evyd13/atom47/README.md

# Atom47

This is the repository for the Atom47. At the moment you'll find Revision 4 AND 5 of the PCB, the final plate file and a design for a 3d printed case.

The Apache2 license apply to all of these works.
