evyd13/atom47/pcb-files/README.md

# Atom47 PCB

## Rev5 (with per key RGB)
Atom47 rev5

## Rev4
Atom47 rev4
