evyd13/atom47/pcb-files/rev5-c/manufacturing/Atom47 Rev5-C BOM.xls

Atom47 Rev5-C BOM
Manufacturer | Manufacturer Part Number (required) | Designator (required) | Qty (required) | Description (required) | Case | SMD ,BGA,LCC,OR TH | Top/Bottom | points (number of contacts the IC has in each board) | Total points (number of contacts per BOM line has) | Comment
Samsung Electro-Mechanics | CL10B104KB8NNNC | C1, C2, C3, C7, C10, C12 | 6 | 100nf capacitor | 0603 | SMD | Bottom
Samsung Electro-Mechanics | CL10A475KP8NNNC | C4 | 1 | 4.7uf capacitor | 0603 | SMD | Bottom
Samsung Electro-Mechanics | CL10A105KB8NNNC | C5 | 1 | 1uf capacitor | 0603 | SMD | Bottom
Samsung Electro-Mechanics | CL10A474KP8NNNC | C6, C9, C11, C13 | 4 | 0.47uf capacitor | 0603 | SMD | Bottom
Shenzhen Zhenhua XinYun Elec | CA45-A-10V-22uF-M | C8 | 1 | 22u tantalum capacitor | 3216 | SMD | Bottom
Changjiang Electronics Tech | 1N4148WS | D1-D24, D26, D27, D29-D43, D45, D47, D49, D50-D52 | 47 | Switching diode | SOD-323 | SMD | Bottom
Walsin Tech Corp | WR06X103JTL | R3, R4, R7 | 3 | 10k ohm resistor | 0603 | SMD | Bottom
Walsin Tech Corp | WR06X203JTL | R5 | 1 | 20k ohm resistor | 0603 | SMD | Bottom
Walsin Tech Corp | WR06X104JTL | R6 | 1 | 100k ohm resistor | 0603 | SMD | Bottom
Walsin Tech Corp | WR06X202JTL | R8, R9 | 2 | 2k ohm resistor | 0603 | SMD | Bottom
Walsin Tech Corp | WR06X220JTL | R1, R2 | 2 | 22 ohm resistor | 0603 | SMD | Bottom
Walsin Tech Corp | WR06X512JTL | R10, R11 | 2 | 5.1k ohm resistor | 0603 | SMD | Bottom
Microchip Tech | ATMEGA32U4-MU | U1 | 1 | Microcontroller | QFN-44 | SMD | Bottom |  |  | Do not substitute
STMicroelectronics | USBLC6-2SC6 | U2 | 1 | Diode ESD | SOT-23-6 | SMD | Bottom |  |  | Do not substitute
Murata Electronics | CSTNE16M0V530000R0 | X1 | 1 | Resonator |  | SMD | Bottom |  |  | Do not substitute
TLC Electronic | TLC-FSMD050 | F1 | 1 | PTC Fuse | 0603 | SMD | Bottom |  |  | Do not substitute
TLC Electronic | TLC-PSMD050 | F2 | 1 | PTC Fuse | 0805 | SMD | Bottom |  |  | Do not substitute
Korean Hroparts Elec | TYPE-C-31-M-12 | J1 | 1 | USB type C receptacle |  | SMD+TH | Bottom |  |  | Do not substitute
LXR-CP | CP-6028SMDRGB-CA | RGB1-RGB24, RGB26,RGB27, RGB28, RGB29-RGB43, RGB45, RGB47, RGB49, RGB50-RGB52 | 48 | RGB led |  | SMD | Bottom |  |  | Do not substitute
Lumissil | IS31FL3733B-QFLS4-TR | U3 | 1 | LED matrix driver | QFN-48 | SMD | Bottom
