evyd13/atom47/case-files/3D printed case.step

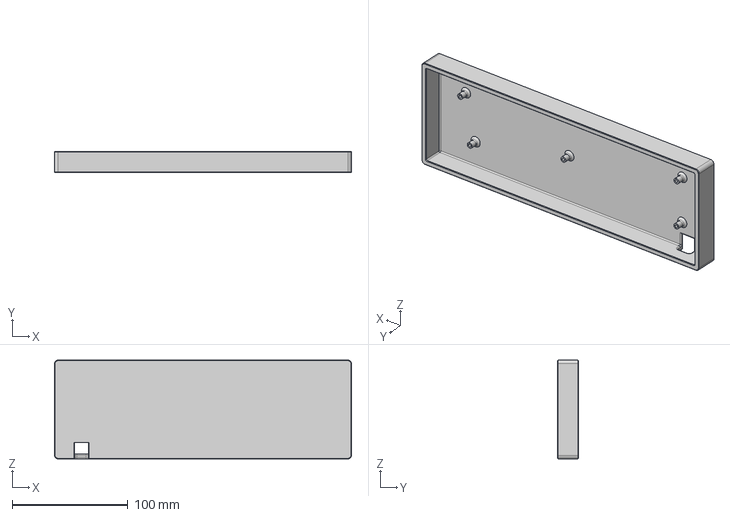
[picture p3: CAD file, 2020-06-01]
case-files/3D printed case.step
256.9 x 18.5 x 85.4 mm
