evyd13/atom47/plate-files/atom47_core_layout.dxf

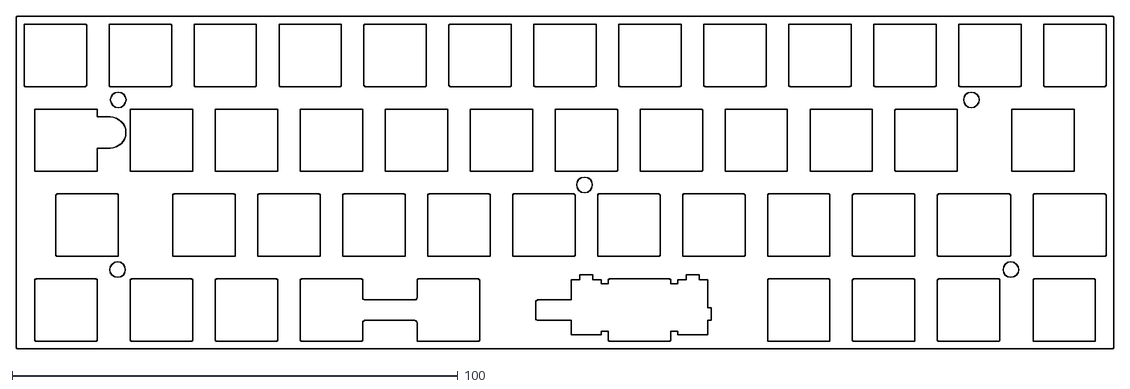
[picture p4: CAD file, 2021-02-24]
plate-files/atom47_core_layout.dxf
246.2 x 74.7
