evyd13/atom47/plate-files/atom47_minitomic_layout.dxf

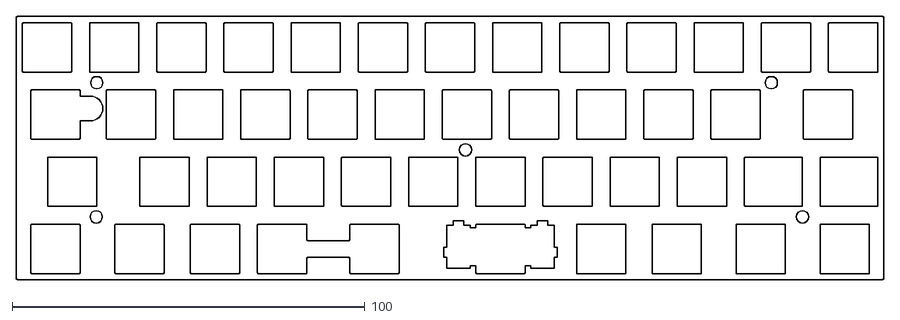
[picture p5: CAD file, 2021-02-24]
plate-files/atom47_minitomic_layout.dxf
246.2 x 74.7
