evyd13/atom47/(list of files, cad)

Other CAD files:
plate-files/atom47_plate.FCStd
case-files/3D printed case.f3z
case-files/3D printed case.stl
