evyd13/atom47/pcb-files/rev5-c/atom47-rev5-c.kicad_pcb

## KiCad design pcb-files/rev5-c/atom47-rev5-c.kicad_pcb (2022-03-01)

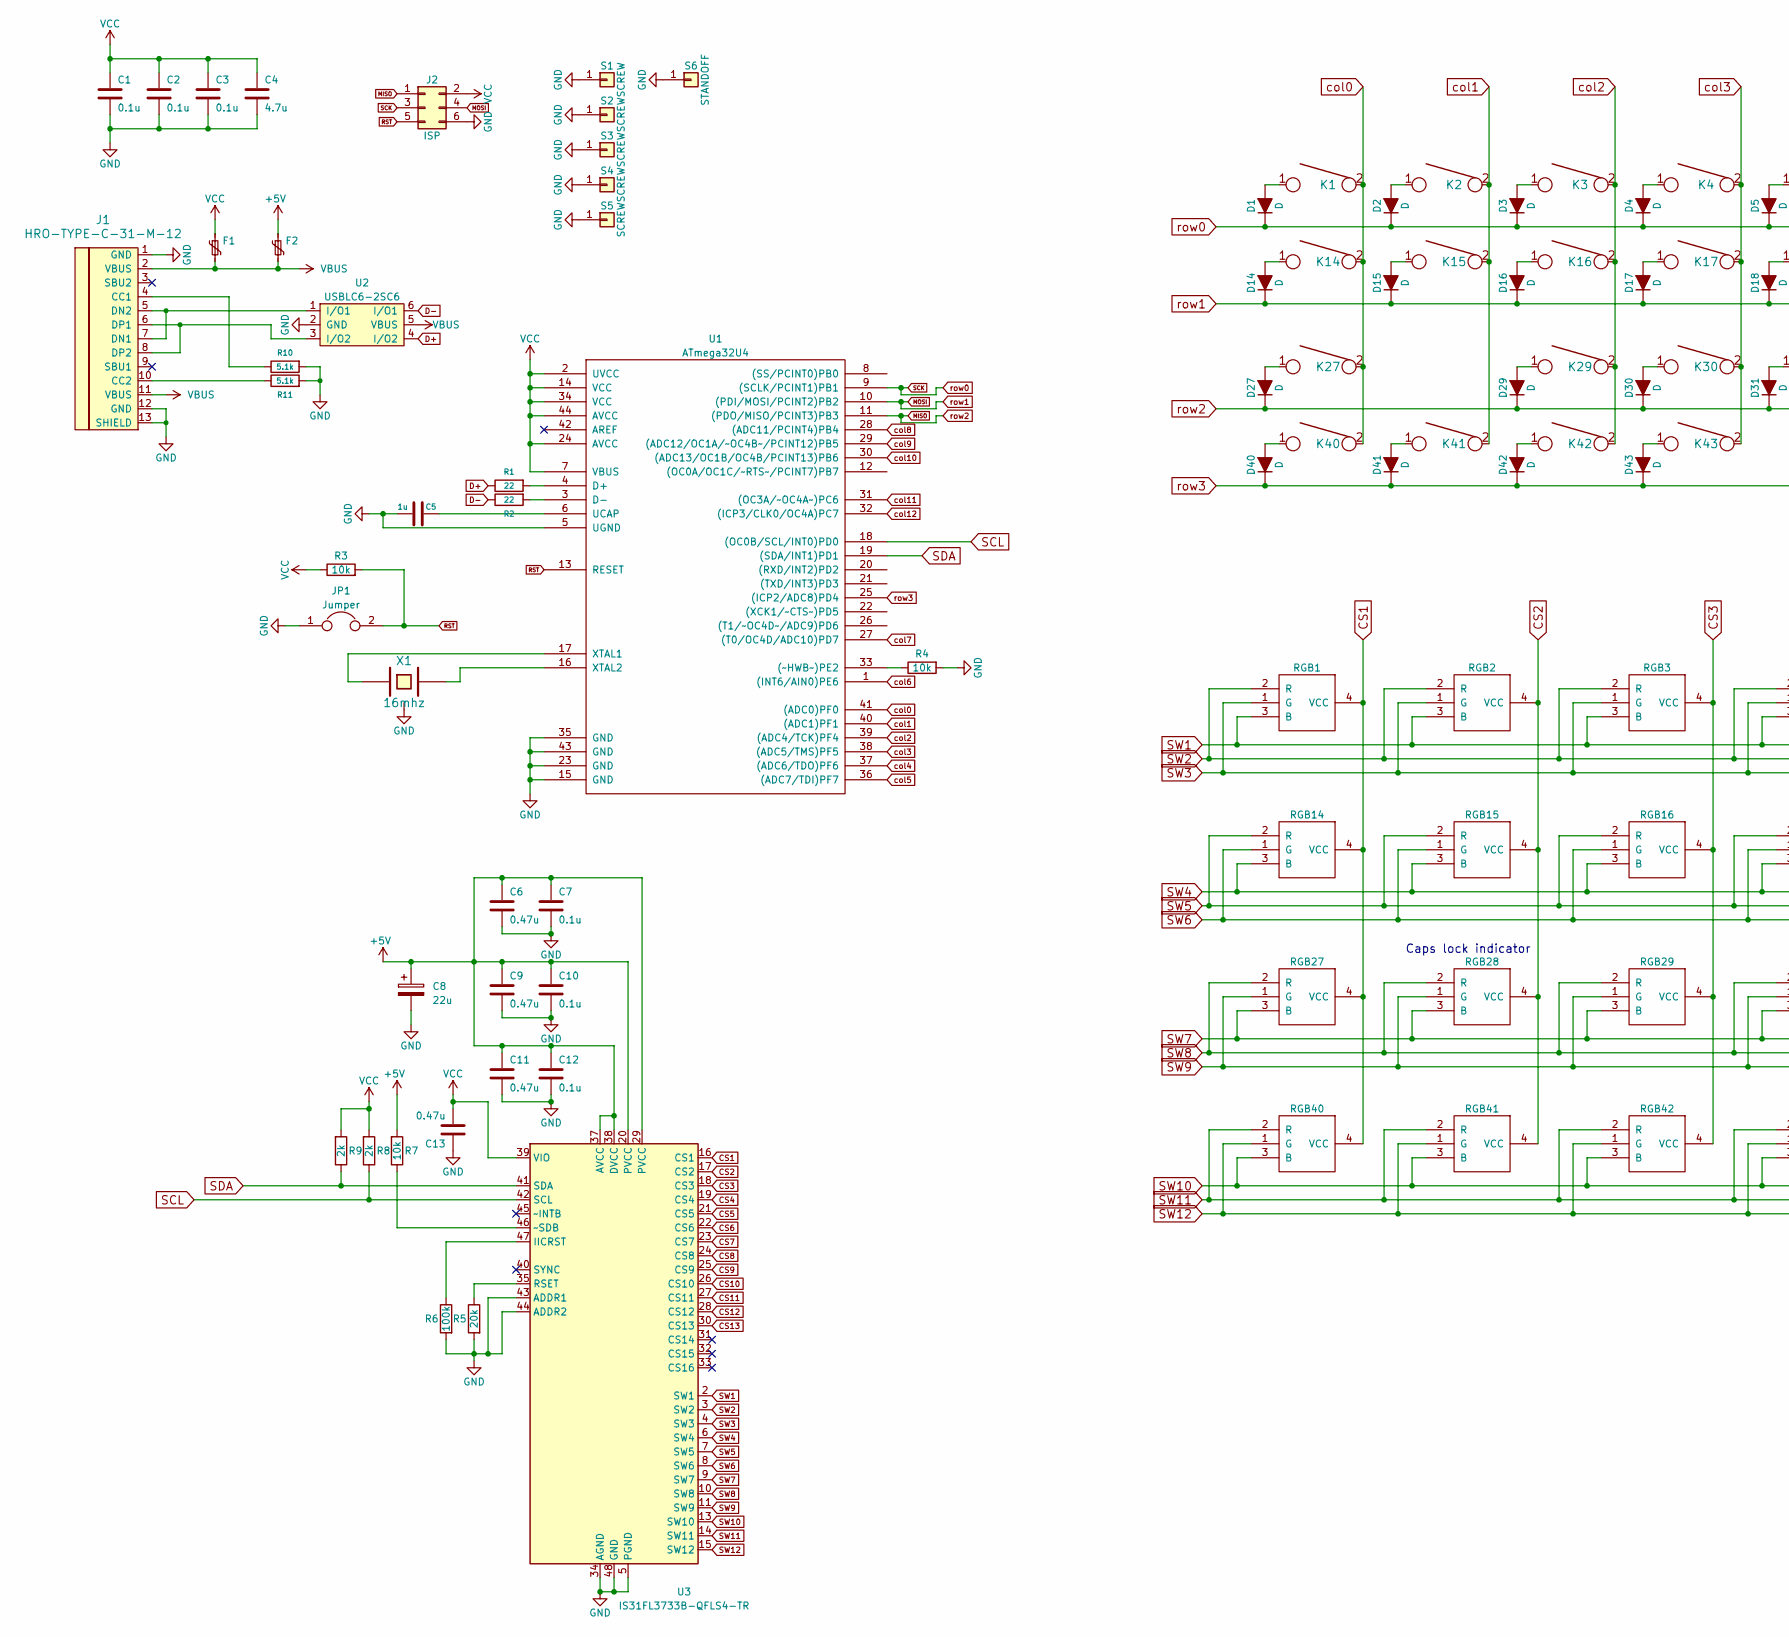
[picture p6: schematic atom47-rev5-c.kicad_sch, part in row 1, column 1]

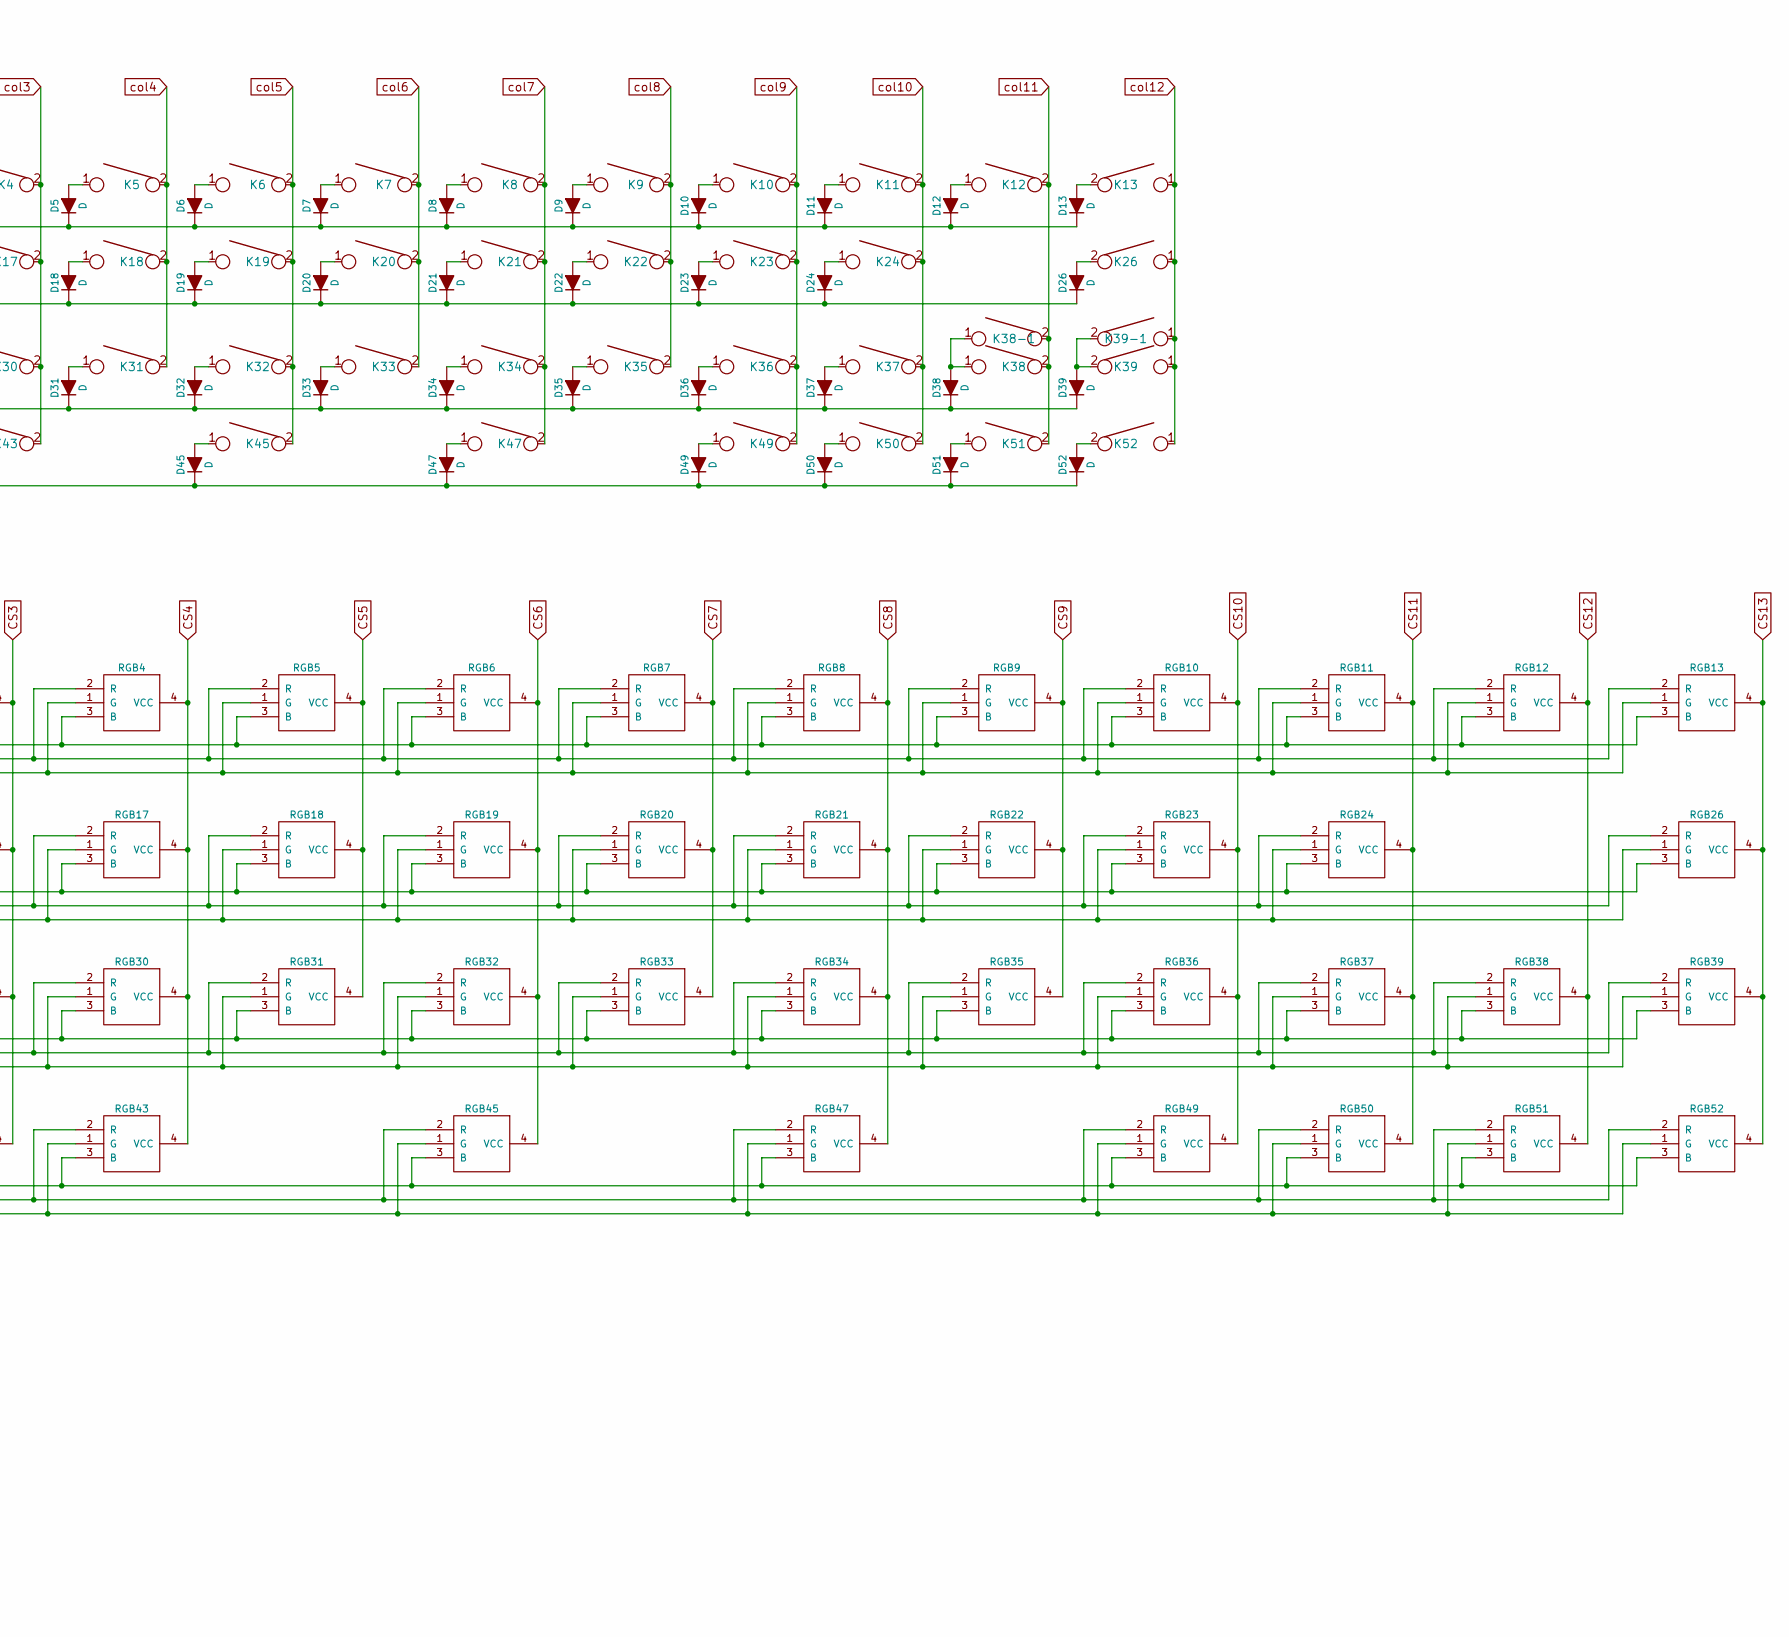
[picture p7: schematic atom47-rev5-c.kicad_sch, part in row 1, column 2]

Parts:
C1, C2, C3, C7, C10, C12: 0.1u; C_0603
C4: 4.7u; C_0603
C5: 1u; C_0603
C6, C9, C11, C13: 0.47u; C_0603
C8: 22u; CP_EIA-3216-10_Kemet-I
D1, D2, D3, D4, D5, D6, D7, D8, D9, D10, D11, D12, D13, D14, D15, D16, D17, D18, D19, D20, D21, D22, D23, D24, D26, D27, D29, D30, D31, D32, D33, D34, D35, D36, D37, D38, D39, D40, D41, D42, D43, D45, D47, D49, D50, D51, D52: D; D_SOD-323
F1: Polyfuse_Small; R_0603
F2: Polyfuse_Small; R_0805
J1: HRO-TYPE-C-31-M-12
J2: ISP; isp_standard
JP1: Jumper; reset
K1, K2, K3, K4, K5, K6, K7, K8, K9, K10, K11, K12, K13, K15, K16, K17, K18, K19, K20, K21, K22, K23, K24, K29, K30, K31, K32, K33, K34, K35, K36, K37, K38-1, K39, K41, K42, K43, K49, K50, K51: KEYSW; CHERRY_PLATE_100H
K14, K38, K39-1, K40, K52: KEYSW; CHERRY_PLATE_125H
K26, K27, K45: KEYSW; CHERRY_PLATE_175H
K47: KEYSW; CHERRY_PLATE_275H
R1, R2: 22; R_0603
R3, R4, R7: 10k; R_0603
R5: 20k; R_0603
R6: 100k; R_0603
R8, R9: 2k; R_0603
R10, R11: 5.1k; R_0603
RGB1, RGB2, RGB3, RGB4, RGB5, RGB6, RGB7, RGB8, RGB9, RGB10, RGB11, RGB12, RGB13, RGB14, RGB15, RGB16, RGB17, RGB18, RGB19, RGB20, RGB21, RGB22, RGB23, RGB24, RGB26, RGB27, RGB28, RGB29, RGB30, RGB31, RGB32, RGB33, RGB34, RGB35, RGB36, RGB37, RGB38, RGB39, RGB40, RGB41, RGB42, RGB43, RGB45, RGB47, RGB49, RGB50, RGB51, RGB52: RGB_6028; CP-6028SMDRGB-CA
S1, S2, S3, S4, S5: SCREW; Vortex_Core_screw
S6: STANDOFF; vortex_standoff
U1: ATmega32U4; ATMEGA32U4-MU
U2: USBLC6-2SC6
U3: IS31FL3733B-QFLS4-TR; QFN-48-1EP_6x6mm_P0.4mm_EP4.2x4.2mm
X1: 16mhz; Resonator_SMD_muRata_CSTNExxV-3Pin-p1.2

Connections:
+5V: C6.1, C7.1, C8.1, C9.1, C10.1, C11.1, C12.1, F2.1, R7.2, U3.20 (PVCC), U3.29 (PVCC), U3.37 (AVCC), U3.38 (DVCC)
CS1: RGB1.4 (VCC), RGB14.4 (VCC), RGB27.4 (VCC), RGB40.4 (VCC), U3.16 (CS1)
CS2: RGB2.4 (VCC), RGB15.4 (VCC), RGB28.4 (VCC), RGB41.4 (VCC), U3.17 (CS2)
CS3: RGB3.4 (VCC), RGB16.4 (VCC), RGB29.4 (VCC), RGB42.4 (VCC), U3.18 (CS3)
CS4: RGB4.4 (VCC), RGB17.4 (VCC), RGB30.4 (VCC), RGB43.4 (VCC), U3.19 (CS4)
CS5: RGB5.4 (VCC), RGB18.4 (VCC), RGB31.4 (VCC), U3.21 (CS5)
CS6: RGB6.4 (VCC), RGB19.4 (VCC), RGB32.4 (VCC), RGB45.4 (VCC), U3.22 (CS6)
CS7: RGB7.4 (VCC), RGB20.4 (VCC), RGB33.4 (VCC), U3.23 (CS7)
CS8: RGB8.4 (VCC), RGB21.4 (VCC), RGB34.4 (VCC), RGB47.4 (VCC), U3.24 (CS8)
CS9: RGB9.4 (VCC), RGB22.4 (VCC), RGB35.4 (VCC), U3.25 (CS9)
CS10: RGB10.4 (VCC), RGB23.4 (VCC), RGB36.4 (VCC), RGB49.4 (VCC), U3.26 (CS10)
CS11: RGB11.4 (VCC), RGB24.4 (VCC), RGB37.4 (VCC), RGB50.4 (VCC), U3.27 (CS11)
CS12: RGB12.4 (VCC), RGB38.4 (VCC), RGB51.4 (VCC), U3.28 (CS12)
CS13: RGB13.4 (VCC), RGB26.4 (VCC), RGB39.4 (VCC), RGB52.4 (VCC), U3.30 (CS13)
D+: R1.1, U2.4 (I/O2)
D-: R2.1, U2.6 (I/O1)
GND: C1.2, C2.2, C3.2, C4.2, C5.2, C6.2, C7.2, C8.2, C9.2, C10.2, C11.2, C12.2, C13.1, J1.1 (GND), J1.12 (GND), J1.13 (SHIELD), J2.6, JP1.1, R4.2, R5.2, R6.2, R10.2, R11.2, S1.1, S2.1, S3.1, S4.1, S5.1, S6.1, U1.5 (UGND), U1.15 (GND), U1.23 (GND), U1.35 (GND), U1.43 (GND), U2.2 (GND), U3.5 (PGND), U3.12 (PGND), U3.34 (AGND), U3.43 (ADDR1), U3.44 (ADDR2), U3.48 (GND), U3.49 (GND), X1.3
MISO: D27.1 (K), D29.1 (K), D30.1 (K), D31.1 (K), D32.1 (K), D33.1 (K), D34.1 (K), D35.1 (K), D36.1 (K), D37.1 (K), D38.1 (K), D39.1 (K), J2.1, U1.11 ((PDO/MISO/PCINT3)PB3)
MOSI: D14.1 (K), D15.1 (K), D16.1 (K), D17.1 (K), D18.1 (K), D19.1 (K), D20.1 (K), D21.1 (K), D22.1 (K), D23.1 (K), D24.1 (K), D26.1 (K), J2.4, U1.10 ((PDI/MOSI/PCINT2)PB2)
unnamed: C5.1, U1.6 (UCAP)
unnamed: D1.2 (A), K1.1
unnamed: D2.2 (A), K2.1
unnamed: D3.2 (A), K3.1
unnamed: D4.2 (A), K4.1
unnamed: D5.2 (A), K5.1
unnamed: D6.2 (A), K6.1
unnamed: D7.2 (A), K7.1
unnamed: D8.2 (A), K8.1
unnamed: D9.2 (A), K9.1
unnamed: D10.2 (A), K10.1
unnamed: D11.2 (A), K11.1
unnamed: D12.2 (A), K12.1
unnamed: D13.2 (A), K13.2
unnamed: D14.2 (A), K14.1
unnamed: D15.2 (A), K15.1
unnamed: D16.2 (A), K16.1
unnamed: D17.2 (A), K17.1
unnamed: D18.2 (A), K18.1
unnamed: D19.2 (A), K19.1
unnamed: D20.2 (A), K20.1
unnamed: D21.2 (A), K21.1
unnamed: D22.2 (A), K22.1
unnamed: D23.2 (A), K23.1
unnamed: D24.2 (A), K24.1
unnamed: D26.2 (A), K26.2
unnamed: D27.2 (A), K27.1
unnamed: D29.2 (A), K29.1
unnamed: D30.2 (A), K30.1
unnamed: D31.2 (A), K31.1
unnamed: D32.2 (A), K32.1
unnamed: D33.2 (A), K33.1
unnamed: D34.2 (A), K34.1
unnamed: D35.2 (A), K35.1
unnamed: D36.2 (A), K36.1
unnamed: D37.2 (A), K37.1
unnamed: D38.2 (A), K38.1, K38-1.1
unnamed: D39.2 (A), K39.2, K39-1.2
unnamed: D40.2 (A), K40.1
unnamed: D41.2 (A), K41.1
unnamed: D42.2 (A), K42.1
unnamed: D43.2 (A), K43.1
unnamed: D45.2 (A), K45.1
unnamed: D47.2 (A), K47.1
unnamed: D49.2 (A), K49.1
unnamed: D50.2 (A), K50.1
unnamed: D51.2 (A), K51.1
unnamed: D52.2 (A), K52.2
unnamed: J1.4 (CC1), R10.1
unnamed: J1.10 (CC2), R11.1
unnamed: R1.2, U1.4 (D+)
unnamed: R2.2, U1.3 (D-)
unnamed: R4.1, U1.33 ((~HWB~)PE2)
unnamed: R5.1, U3.35 (RSET)
unnamed: R6.1, U3.47 (IICRST)
unnamed: R7.1, U3.46 (~SDB)
unnamed: U1.16 (XTAL2), X1.2
unnamed: U1.17 (XTAL1), X1.1
unnamed: J1.5 (DN2), J1.7 (DN1), U2.1 (I/O1)
unnamed: J1.6 (DP1), J1.8 (DP2), U2.3 (I/O2)
RST: J2.5, JP1.2, R3.2, U1.13 (RESET)
SCK: D1.1 (K), D2.1 (K), D3.1 (K), D4.1 (K), D5.1 (K), D6.1 (K), D7.1 (K), D8.1 (K), D9.1 (K), D10.1 (K), D11.1 (K), D12.1 (K), D13.1 (K), J2.3, U1.9 ((SCLK/PCINT1)PB1)
SCL: R8.1, U1.18 ((OC0B/SCL/INT0)PD0), U3.42 (SCL)
SDA: R9.1, U1.19 ((SDA/INT1)PD1), U3.41 (SDA)
SW1: RGB1.3 (B), RGB2.3 (B), RGB3.3 (B), RGB4.3 (B), RGB5.3 (B), RGB6.3 (B), RGB7.3 (B), RGB8.3 (B), RGB9.3 (B), RGB10.3 (B), RGB11.3 (B), RGB12.3 (B), RGB13.3 (B), U3.2 (SW1)
SW2: RGB1.2 (R), RGB2.2 (R), RGB3.2 (R), RGB4.2 (R), RGB5.2 (R), RGB6.2 (R), RGB7.2 (R), RGB8.2 (R), RGB9.2 (R), RGB10.2 (R), RGB11.2 (R), RGB12.2 (R), RGB13.2 (R), U3.3 (SW2)
SW3: RGB1.1 (G), RGB2.1 (G), RGB3.1 (G), RGB4.1 (G), RGB5.1 (G), RGB6.1 (G), RGB7.1 (G), RGB8.1 (G), RGB9.1 (G), RGB10.1 (G), RGB11.1 (G), RGB12.1 (G), RGB13.1 (G), U3.4 (SW3)
SW4: RGB14.3 (B), RGB15.3 (B), RGB16.3 (B), RGB17.3 (B), RGB18.3 (B), RGB19.3 (B), RGB20.3 (B), RGB21.3 (B), RGB22.3 (B), RGB23.3 (B), RGB24.3 (B), RGB26.3 (B), U3.6 (SW4)
SW5: RGB14.2 (R), RGB15.2 (R), RGB16.2 (R), RGB17.2 (R), RGB18.2 (R), RGB19.2 (R), RGB20.2 (R), RGB21.2 (R), RGB22.2 (R), RGB23.2 (R), RGB24.2 (R), RGB26.2 (R), U3.7 (SW5)
SW6: RGB14.1 (G), RGB15.1 (G), RGB16.1 (G), RGB17.1 (G), RGB18.1 (G), RGB19.1 (G), RGB20.1 (G), RGB21.1 (G), RGB22.1 (G), RGB23.1 (G), RGB24.1 (G), RGB26.1 (G), U3.8 (SW6)
SW7: RGB27.3 (B), RGB28.3 (B), RGB29.3 (B), RGB30.3 (B), RGB31.3 (B), RGB32.3 (B), RGB33.3 (B), RGB34.3 (B), RGB35.3 (B), RGB36.3 (B), RGB37.3 (B), RGB38.3 (B), RGB39.3 (B), U3.9 (SW7)
SW8: RGB27.2 (R), RGB28.2 (R), RGB29.2 (R), RGB30.2 (R), RGB31.2 (R), RGB32.2 (R), RGB33.2 (R), RGB34.2 (R), RGB35.2 (R), RGB36.2 (R), RGB37.2 (R), RGB38.2 (R), RGB39.2 (R), U3.10 (SW8)
SW9: RGB27.1 (G), RGB28.1 (G), RGB29.1 (G), RGB30.1 (G), RGB31.1 (G), RGB32.1 (G), RGB33.1 (G), RGB34.1 (G), RGB35.1 (G), RGB36.1 (G), RGB37.1 (G), RGB38.1 (G), RGB39.1 (G), U3.11 (SW9)
SW10: RGB40.3 (B), RGB41.3 (B), RGB42.3 (B), RGB43.3 (B), RGB45.3 (B), RGB47.3 (B), RGB49.3 (B), RGB50.3 (B), RGB51.3 (B), RGB52.3 (B), U3.13 (SW10)
SW11: RGB40.2 (R), RGB41.2 (R), RGB42.2 (R), RGB43.2 (R), RGB45.2 (R), RGB47.2 (R), RGB49.2 (R), RGB50.2 (R), RGB51.2 (R), RGB52.2 (R), U3.14 (SW11)
SW12: RGB40.1 (G), RGB41.1 (G), RGB42.1 (G), RGB43.1 (G), RGB45.1 (G), RGB47.1 (G), RGB49.1 (G), RGB50.1 (G), RGB51.1 (G), RGB52.1 (G), U3.15 (SW12)
VBUS: F1.2, F2.2, J1.2 (VBUS), J1.11 (VBUS), U2.5 (VBUS)
VCC: C1.1, C2.1, C3.1, C4.1, C13.2, F1.1, J2.2, R3.1, R8.2, R9.2, U1.2 (UVCC), U1.7 (VBUS), U1.14 (VCC), U1.24 (AVCC), U1.34 (VCC), U1.44 (AVCC), U3.39 (VIO)
col0: K1.2, K14.2, K27.2, K40.2, U1.41 ((ADC0)PF0)
col1: K2.2, K15.2, K41.2, U1.40 ((ADC1)PF1)
col2: K3.2, K16.2, K29.2, K42.2, U1.39 ((ADC4/TCK)PF4)
col3: K4.2, K17.2, K30.2, K43.2, U1.38 ((ADC5/TMS)PF5)
col4: K5.2, K18.2, K31.2, U1.37 ((ADC6/TDO)PF6)
col5: K6.2, K19.2, K32.2, K45.2, U1.36 ((ADC7/TDI)PF7)
col6: K7.2, K20.2, K33.2, U1.1 ((INT6/AIN0)PE6)
col7: K8.2, K21.2, K34.2, K47.2, U1.27 ((T0/OC4D/ADC10)PD7)
col8: K9.2, K22.2, K35.2, U1.28 ((ADC11/PCINT4)PB4)
col9: K10.2, K23.2, K36.2, K49.2, U1.29 ((ADC12/OC1A/~OC4B~/PCINT12)PB5)
col10: K11.2, K24.2, K37.2, K50.2, U1.30 ((ADC13/OC1B/OC4B/PCINT13)PB6)
col11: K12.2, K38.2, K38-1.2, K51.2, U1.31 ((OC3A/~OC4A~)PC6)
col12: K13.1, K26.1, K39.1, K39-1.1, K52.1, U1.32 ((ICP3/CLK0/OC4A)PC7)
row3: D40.1 (K), D41.1 (K), D42.1 (K), D43.1 (K), D45.1 (K), D47.1 (K), D49.1 (K), D50.1 (K), D51.1 (K), D52.1 (K), U1.25 ((ICP2/ADC8)PD4)

Notes on the sheet:
Caps lock indicator

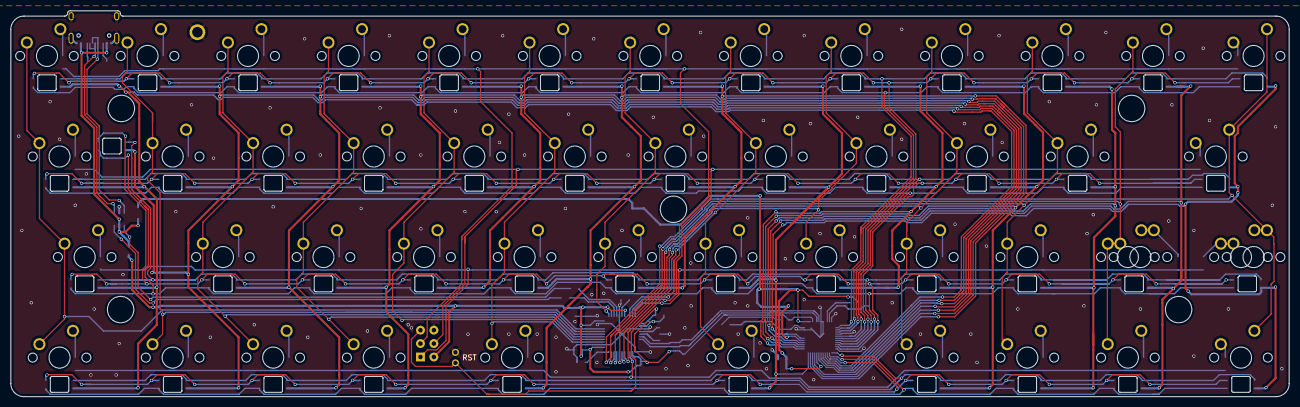
[picture p8: board atom47-rev5-c.kicad_pcb from above]

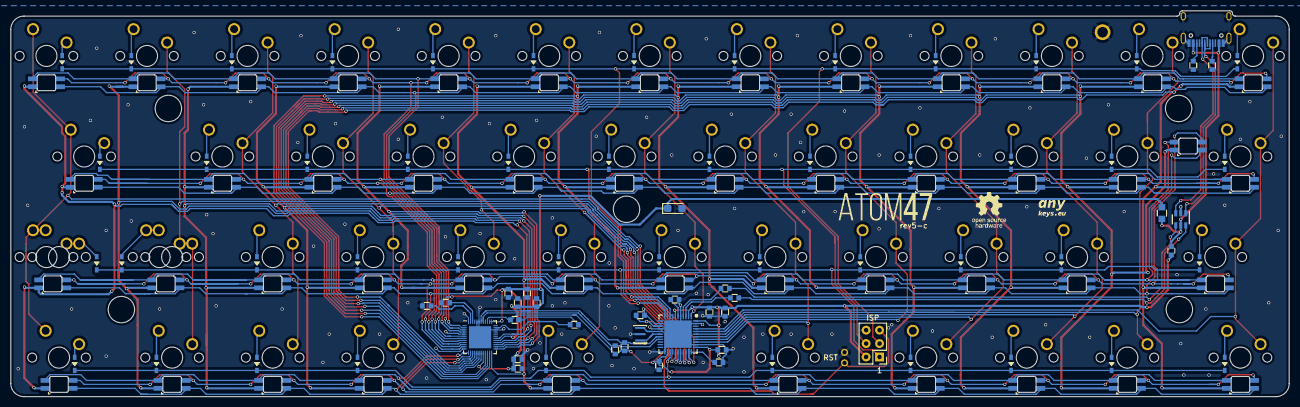
[picture p9: board atom47-rev5-c.kicad_pcb from below]

Board: 2 copper layers, 242.2 x 73.1 mm, 183 parts (127 on the bottom side), 111 nets.
