evyd13/atom47/(threads)

Thread 4 (2021-06-28):

How to order the board?

vitalykorolev, 2021-06-28:
It seems that this board is not for sale anywhere. Is it possible to place an individual order with the provided schematics? Any advice on the service and how to place such order would be appreciated. Thank you!

PancakeGoon, 2021-06-29:
Some board printing services require a MOQ, but luckily there _are_ sites that offer 1 or 2 count custom PCB printing. One of the most popular & accessible sites is [jlcpcb.com](jlcpcb.com).

You need to download the "Gerber Files" for it in the Atom47 git, and then just upload them into the jlcpcb PCB Prototype file uploader. Simple as that for the most part (might need some minor dimensions tweaks depending on the open source file author). Theres also [PCBway.com](PCB.way.com).

If I remember correctly, they also offer steel/alum/POM plate printing as well, but don't quote me on that. Either way, the stock Core's plate is obviously compatible, but thought I'd let you know for future reference.

vitalykorolev, 2021-06-29:
@PancakeGoon Thank you for the reply! I tried uploading "gerber" files to JLCPCB.com and it looks like the design is interpreted correctly. It seems that they can make at minimum 5 boards for about $20, but that doesn't include SMT assembly. I got a quote on PCBWAY with assembly and it came to $135 for 5 boards.

Thread 5 (2022-02-24):

Possible revision with USB-C

vitalykorolev, 2022-02-24:
Just noticed that there is rev5 of the PCB. How hard would it be to design a version with USB-C port instead of micro USB?

evyd13, 2022-02-25:
Wouldn't be difficult at all, but it would break compatibility with the Vortex Core case.

vitalykorolev, 2022-02-25:
True, but if it's in the same location, then the hole needs to be just a bit bigger. My case is already modified as I tried to replace the port on my board. Unfortunately, I failed and now looking for a replacement board.

evyd13, 2022-02-25:
I made a usb-c version locally, here's the difference in PCB footprint:
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

Are you sure this will work?

vitalykorolev, 2022-02-25:
I don't see why not. I'd have to make the hole a bit bigger to fit the new port, but it's a small sacrifice for a hugely more convenient standard. It'd be interesting to see if there are a few others who would be interested in this so that ordering PCBs would make sense.

evyd13, 2022-03-01:
https://github.com/evyd13/atom47/tree/master/pcb-files/rev5-c

Here you go! Re-open the issue if needed.

Closed 2022-03-01.
