evyd13/atom47/(commit log)

2020-06-01 First upload
    [3D printed case.f3z, 3D printed case.step, 3D printed case.stl]
2021-02-24 Upload PCB/plate files
    [3D printed case.f3z, 3D printed case.step, 3D printed case.stl, Atom47 Rev4 BOM.xls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]
2022-02-20 Rename pcb-files to pcb-files/rev4
    pcb revs get their own folders
    [Atom47 Rev4 BOM.xls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]
2022-02-20 Upload rev5 files
    [Atom47 Rev5 BOM.xls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]
2022-03-01 Upload rev5-c files
    [Atom47 Rev5-C BOM.xls, atom47-rev5-c.kicad_pcb, atom47-rev5-c.kicad_sch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]
2022-03-01 Change folder name for rev5-c
    [Atom47 Rev5-C BOM.xls, atom47-rev5-c.kicad_pcb, atom47-rev5-c.kicad_sch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]
